Adminiuga/Skyduino-Hardware/(commit log)

2024-08-12 Add PCB & SCH diff outputs
    [Skyduino-Hardware.kibot.yaml]
2024-08-12 Diff on push & pull requests
    [Skyduino-Hardware.kibot.yaml]
2024-08-12 Should definitions: section be at the end?
    [Skyduino-Hardware.kibot.yaml]
2024-08-12 It does not like the definitions: section. Is the doc wrong?
    [Skyduino-Hardware.kibot.yaml]
2024-08-12 Upload pcb & sch diffs individually
2024-08-13 Remove LSE from schematic
    [SkyDuino-CPU.kicad_sch]
2024-08-13 Remove LSE from PCB
    [SkyDuino-Hardware.kicad_pcb]
2024-08-13 Replace L1 with Sunlord SWPA4030S180MT
    [SkyDuino-Hardware.kicad_pcb, SkyDuino-Hardware.kicad_sch]
2024-08-13 Replace 20MHz Oscilator with JLCPCB one
    [SkyDuino-CPU.kicad_sch, SkyDuino-Hardware.kicad_pcb]
2024-08-13 Increase SSR & Relay track width
    [SkyDuino-Hardware.kicad_pcb]
2024-08-13 Increase 5v track width
    [SkyDuino-Hardware.kicad_pcb]
2024-08-14 Upload diffs to Releases (#16)
    * Diff are uploaded individually for PCB & Schematic
    * On releases, make the diff against last release.
2024-08-14 Print "last tag" to be used for Kidiff (#19)
